Mysteringz/mini_IOT_Thermal_sensing/PCB/CrowdAware Node v1.0.pdf

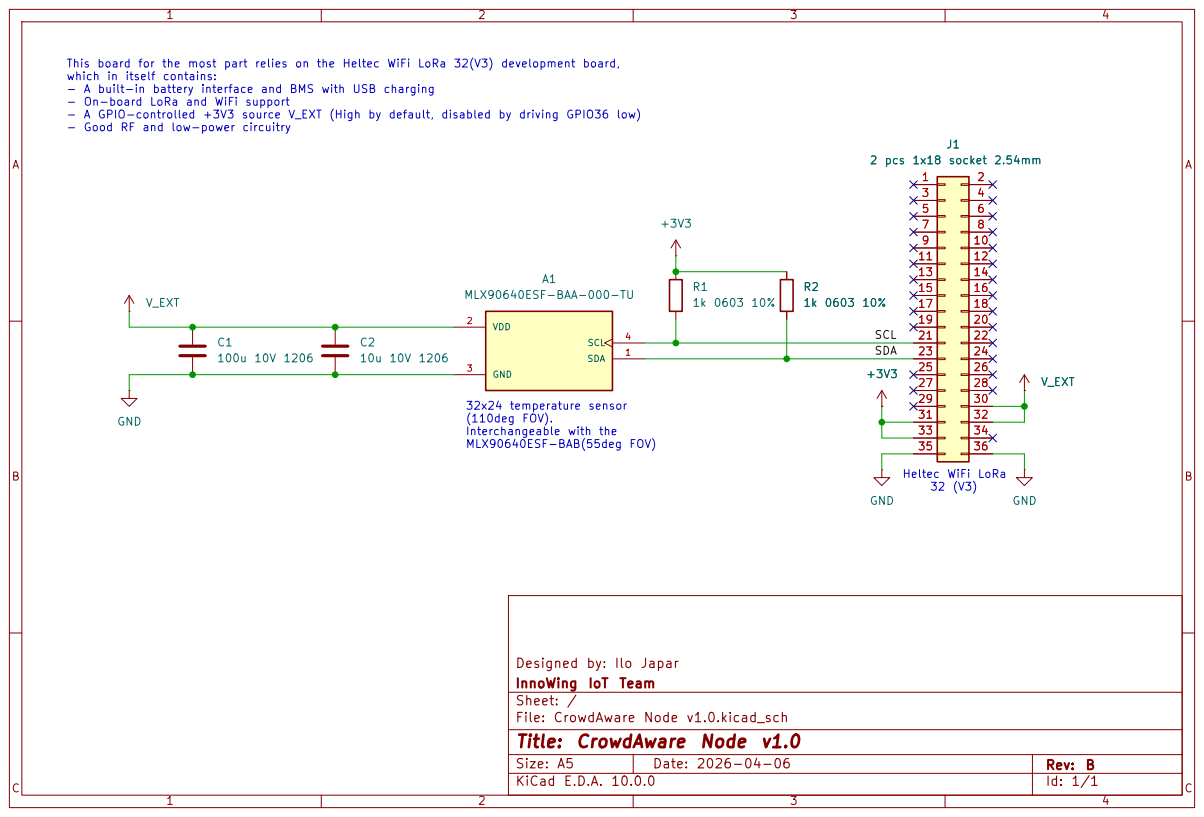
[picture p1: page 1]
Size: A5; Rev: B; V_EXT; J1 2 pcs 1x18 socket 2.54mm; GND; SDA; VDD 2; GND 3; SCL; 4 A1 MLX90640ESF⁻BAA⁻000⁻TU; GND +3V3 R1

This board for the most part relies on the Heltec WiFi LoRa 32(V3) development board, which in itself contains: - A built⁻in battery interface and BMS with USB charging - On⁻board LoRa and WiFi support - A GPIO⁻controlled +3V3 source V_EXT (High by default, disabled by driving GPIO36 low) - Good RF and low⁻power circuitry

Heltec WiFi LoRa 32 (V3) +3V3 R2

SDA SCL 32x24 temperature sensor

(110deg FOV).
Interchangeable with the
MLX90640ESF⁻BAB(55deg FOV)

Designed by: Ilo Japar GND

InnoWing IoT Team
Sheet: /
File: CrowdAware Node v1.0.kicad_sch
Title: CrowdAware Node v1.0
C Date: 2026⁻04-06 KiCad E.D.A. 10.0.0

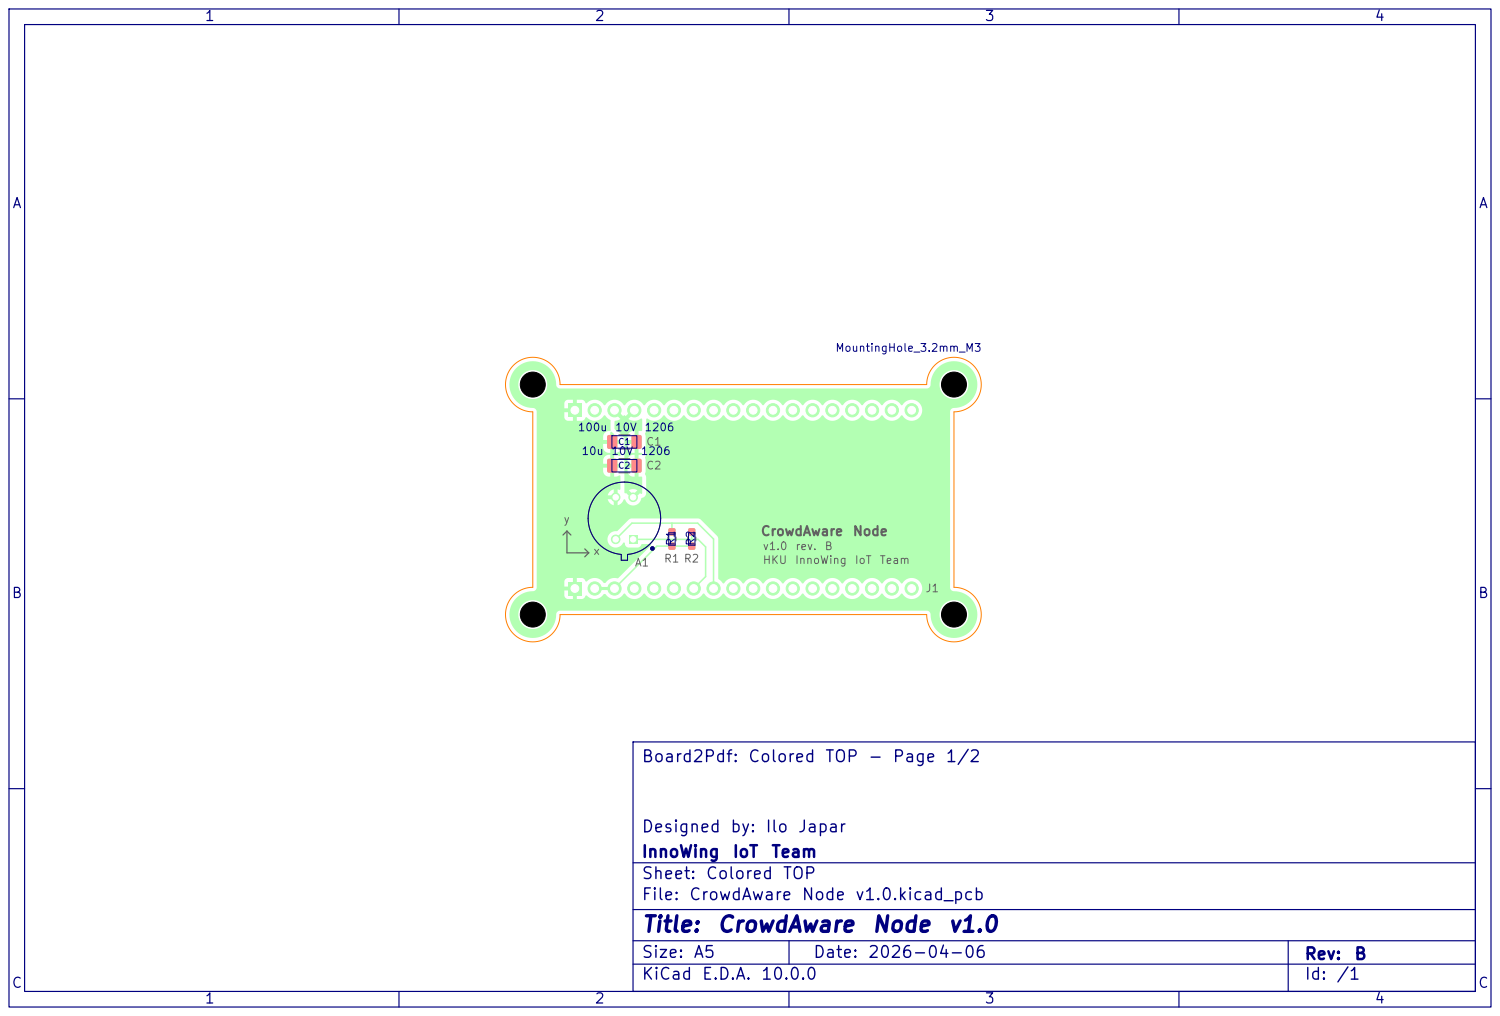
[picture p2: page 2]
Size: A5; Rev: B; MountingHole_3.2mm_M3 R1

CrowdAware Node
v1.0 rev. B HKU InnoWing IoT Team

Board2Pdf: Colored TOP - Page 1/2

Designed by: Ilo Japar
InnoWing IoT Team
Sheet: Colored TOP
File: CrowdAware Node v1.0.kicad_pcb
Title: CrowdAware Node v1.0
C Date: 2026⁻04⁻06 KiCad E.D.A. 10.0.0

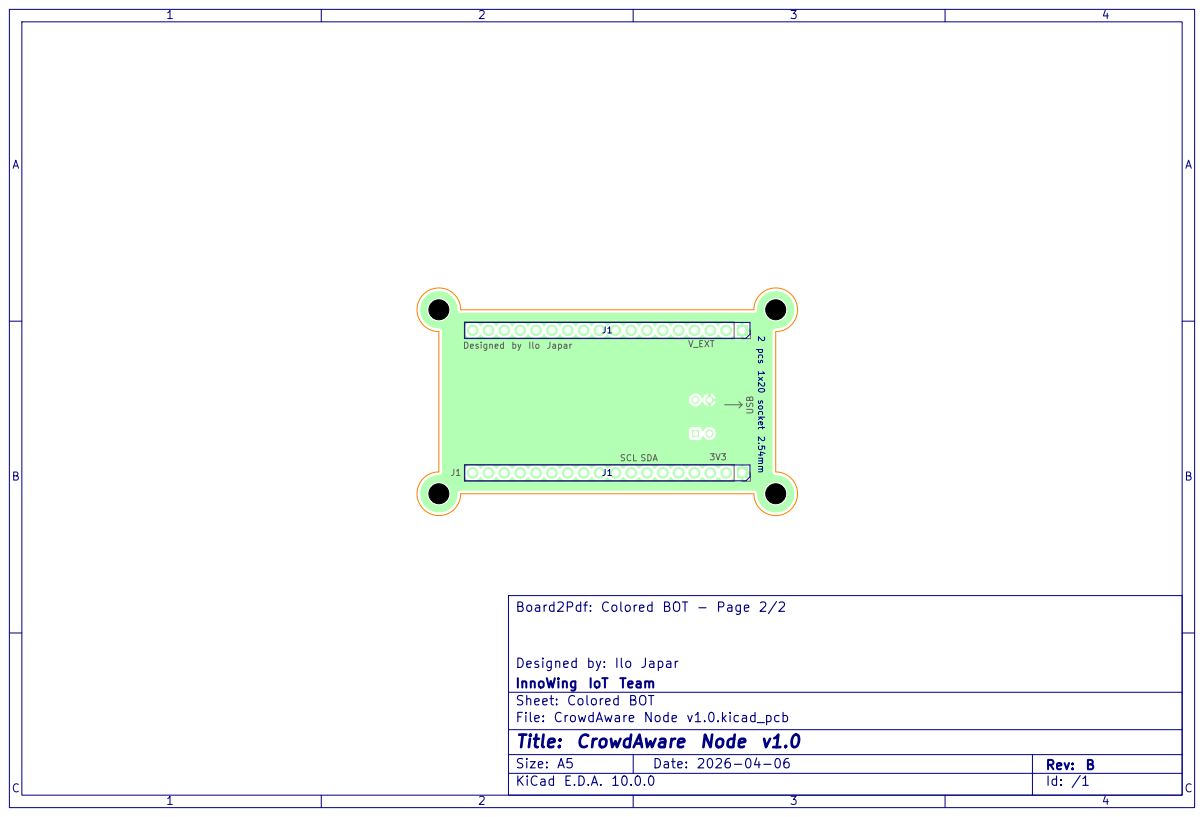
[picture p3: page 3]
Designed by Ilo Japar; V_EXT SCL SDA; USB; Size: A5; Rev: B

Board2Pdf: Colored BOT - Page 2/2 ² pcs 1x20 socket 2.54mm

Designed by: Ilo Japar
InnoWing IoT Team
Sheet: Colored BOT
File: CrowdAware Node v1.0.kicad_pcb
Title: CrowdAware Node v1.0
C Date: 2026⁻04⁻06 KiCad E.D.A. 10.0.0
