Mysteringz/mini_IOT_Thermal_sensing/PCB/CrowdAware Node v1.0.kicad_pcb

## KiCad design PCB/CrowdAware Node v1.0.kicad_pcb (2026-04-08)

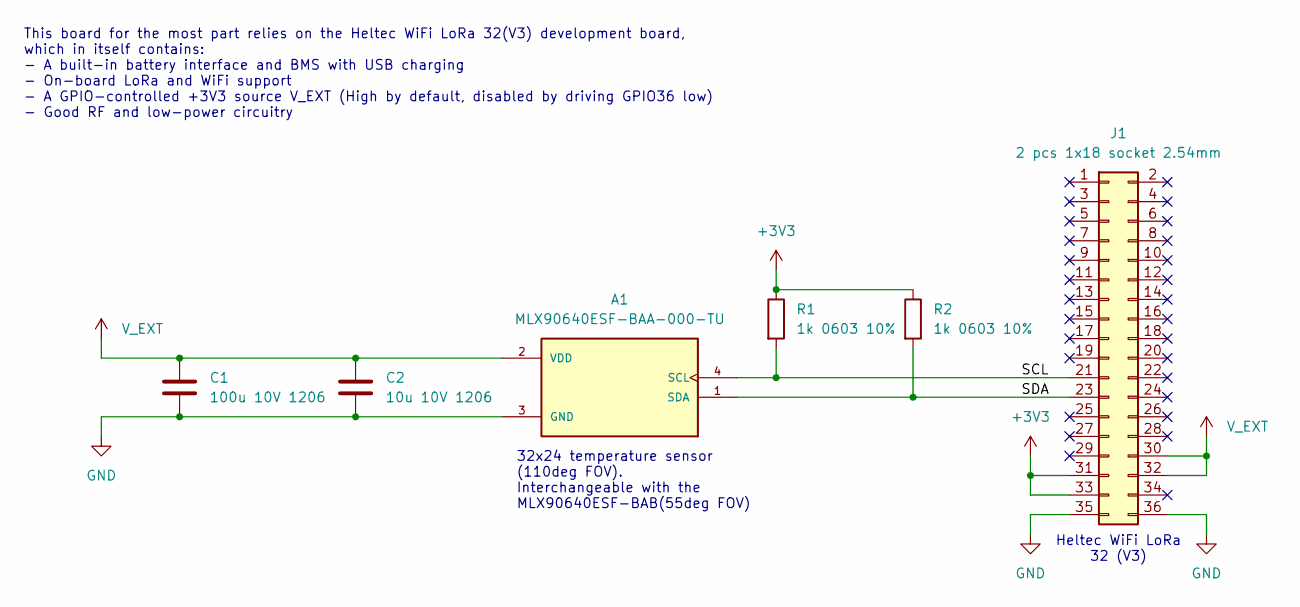
[picture p4: schematic CrowdAware Node v1.0.kicad_sch, CrowdAware Node v1.0]

Parts:
A1: MLX90640ESF-BAA-000-TU; PARTREV 11; Mouser No. 482-MLX90640ESFBAASP
C1: 100u 10V 1206; C_1206_3216Metric_Pad1.33x1.80mm_HandSolder; Mouser No. 81-GRM31CR61A107MA8L
C2: 10u 10V 1206; C_1206_3216Metric_Pad1.33x1.80mm_HandSolder; Mouser No. 81-GRM319R61A106KE9J
J1: 2 pcs 1x18 socket 2.54mm; Connector_HeltecWiFiLoRa32v3; Mouser No. 571-6-535541-6
R1, R2: 1k 0603 10%; R_0603_1608Metric_Pad0.98x0.95mm_HandSolder; Mouser No. 603-SR0603JR-7T1KL

Connections:
+3V3: J1.31, J1.33, R1.1, R2.1
/SCL: A1.4 (SCL), J1.21, R1.2
/SDA: A1.1 (SDA), J1.23, R2.2
GND: A1.3 (GND), C1.2, C2.2, J1.35, J1.36
V_EXT: A1.2 (VDD), C1.1, C2.1, J1.30, J1.32

Notes on the sheet:
This board for the most part relies on the Heltec WiFi LoRa 32(V3) development board, which in itself contains: - A built-in battery interface and BMS with USB charging - On-board LoRa and WiFi support - A GPIO-controlled +3V3 source V_EXT (High by default, disabled by driving GPIO36 low) - Good RF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
Heltec WiFi LoRa 32 (V3)
32x24 temperature sensor (110deg FOV). Interchangeable with the MLX90640ESF-BAB(55deg FOV)

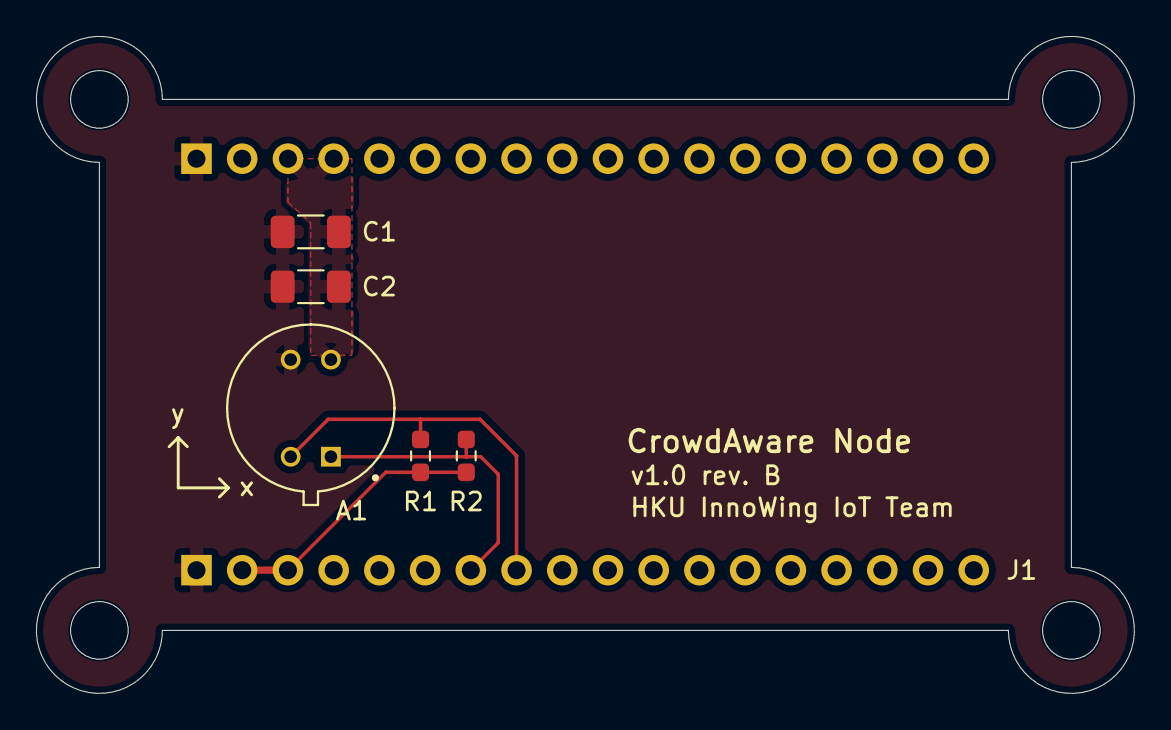
[picture p5: board CrowdAware Node v1.0.kicad_pcb from above]

Board: 2 copper layers, 61.0 x 36.5 mm, 6 parts (1 on the bottom side), 5 nets.
