Mysteringz/mini_IOT_Thermal_sensing/(commit log)

2025-06-11 Create PCB
2025-06-11 SCH Document
    [ThermalCamV1.sch]
2025-06-11 Files for Altium (Schematics)
    [ThermalCamSchLib.SchLib, ThermalCamV1.PrjPcb, ThermalCamV1.SchDoc]
2025-06-19 Create Spacer
2025-06-19 Version 1 of Thermal Camera PCB
    [ThermalCamSchLib.SchLib, ThermalCamV1.PcbDoc, ThermalCamV1.PcbLib, ThermalCamV1.PrjPcb, ThermalCamV1.SchDoc]
2025-06-19 Delete Hardware/PCB directory
    Migrated over to home folder
    [ThermalCamSchLib.SchLib, ThermalCamV1.PrjPcb, ThermalCamV1.SchDoc, ThermalCamV1.sch]
2025-06-19 Delete PCB/Blank
    Cleanup
2025-06-19 Delete PCB/ThermalCamV1/Spacer
    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
2025-07-07 Delete PCB/ThermalCamV1 directory
    Updating to V1.2
    [ThermalCamSchLib.SchLib, ThermalCamV1.PcbDoc, ThermalCamV1.PcbLib, ThermalCamV1.PrjPcb, ThermalCamV1.SchDoc]
2025-07-07 Spacer for PCB dir
2025-07-07 Updated to V1.1
    [ThermalCamSchLib.SchLib, ThermalCamV1.PcbLib, ThermalCamV1.PrjPcb, ThermalCamV1.SchDoc, ThermalCamV1_1.PcbDoc]
2025-07-30 deleted broken files. Updated new version of normal thermal node with rgb based on people detection.
    [Rev2.4_thermal_node.ino]
2025-08-01 Fixed num of LEDs. Change the indicator color to green.
    [Rev2.4_thermal_node.ino]
2025-10-03 Update Readme with usage and requirements
    Added usage information about Arduino serial monitor and image processing requirements.
2025-10-03 Add STM32 code, model conversion pipeline, and ultralytics development
2026-03-02 Added PCB Folder
    [ThermalCamPcbLib.PcbLib, ThermalCamSchLib.SchLib, ThermalCamV2.PcbDoc, ThermalCamV2.SchDoc]
2026-03-04 Updated README.md due to deprecated Heltec board, structured into src files for Arduino, refactored out Web_interface
2026-03-04 Added incomplete README.md to thermal node 2.4, refactored camera_algorithm and web_interface
2026-03-05 Decided there was no point in putting everythin in subdirectories since Arduino is messy
2026-03-05 Fixed existing problems in Camera_algorithm, abstracted away struct_message into its own file (Data_packet), beginning refactoring for LED_Controller
    [MLX90640_I2C_Driver.cpp]
2026-03-06 Fixed led_set double declaration, factored out LoRaWAN server code to Web_interface, moved wifi, host, and ssid into user config
2026-03-06 Defined macros for LED Control
2026-03-11 Set correct lora params, fixed incorrect sequence flow, added serial print messages for more granular debugging
2026-03-30 Configured LoRa params as macros, added macros for led colours
2026-03-30 chore(repo): remove vendored YOLOv5 and third-party project
    Delete previously committed full source copies of YOLOv5 and another external OSS project.
    This cleans the repo and sets up a dependency-based install flow to be documented in the upcoming refactor README.
2026-03-30 Reorganize project structure and add PCB files
    - Move node firmware files to Firmware/node directory
    - Reorganize PCB files to PCB Files directory with Gerber outputs
    - Clean up obsolete visualization scripts
    - Update .gitignore for new structure
    [Node.PcbDoc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]
2026-04-05 Migrated to KiCad. Simplified PCB
    [CrowdAware Node v1.0-B_Cu.gbl, CrowdAware Node v1.0-B_Mask.gbs, CrowdAware Node v1.0-B_Paste.gbp, CrowdAware Node v1.0-B_Silkscreen.gbo, CrowdAware Node v1.0-Edge_Cuts.gm1, CrowdAware Node v1.0-F_Cu.gtl, CrowdAware Node v1.0-F_Mask.gts, CrowdAware Node v1.0-F_Paste.gtp]
2026-04-06 Revised routing, changed pullup to 3v3
    [CrowdAware Node v1.0-B_Cu.gbl, CrowdAware Node v1.0-B_Mask.gbs, CrowdAware Node v1.0-B_Paste.gbp, CrowdAware Node v1.0-B_Silkscreen.gbo, CrowdAware Node v1.0-Edge_Cuts.gm1, CrowdAware Node v1.0-F_Cu.gtl, CrowdAware Node v1.0-F_Mask.gts, CrowdAware Node v1.0-F_Paste.gtp]
2026-04-06 Minor adjustment to trace spacing
    [CrowdAware Node v1.0-B_Cu.gbl, CrowdAware Node v1.0-B_Mask.gbs, CrowdAware Node v1.0-B_Paste.gbp, CrowdAware Node v1.0-B_Silkscreen.gbo, CrowdAware Node v1.0-Edge_Cuts.gm1, CrowdAware Node v1.0-F_Cu.gtl, CrowdAware Node v1.0-F_Mask.gts, CrowdAware Node v1.0-F_Paste.gtp]
2026-04-06 PCB file from previous revision
    [CrowdAware Node v1.0.kicad_pcb]
2026-04-08 Include BOM, Adjusted footprints to match
    [CrowdAware Node v1.0-B_Cu.gbl, CrowdAware Node v1.0-B_Mask.gbs, CrowdAware Node v1.0-B_Paste.gbp, CrowdAware Node v1.0-B_Silkscreen.gbo, CrowdAware Node v1.0-Edge_Cuts.gm1, CrowdAware Node v1.0-F_Cu.gtl, CrowdAware Node v1.0-F_Mask.gts, CrowdAware Node v1.0-F_Paste.gtp]
